BlazingPlanet/TVC-Flight-Software/flight_1/flight1.gif

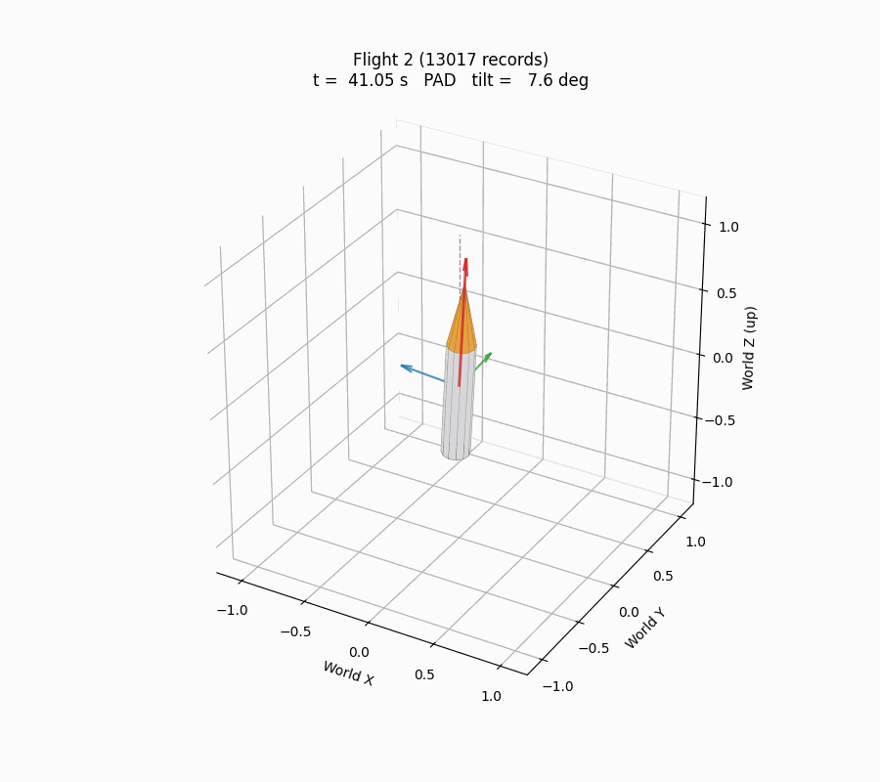
flight_1/flight1.gif
