BlazingPlanet/TVC-Flight-Software/TVC_Flight_Software/TVC_Flight_Software.ioc

Mcu.UserName=STM32F411CEUx
PA2.Signal=USART2_TX
PA3.Signal=USART2_RX
PA5.Signal=SPI1_SCK
PA6.Signal=SPI1_MISO
PA7.Signal=SPI1_MOSI
PB0.Signal=S_TIM3_CH3
PB10.GPIO_Label=FLASH_CS
PB10.Signal=GPIO_Output
PB12.GPIO_Label=IMU_CS
PB12.Signal=GPIO_Output
PB4.Signal=S_TIM3_CH1
PB5.Signal=S_TIM3_CH2
PB6.GPIO_Label=BMP_CS
PB6.Signal=GPIO_Output
