BlazingPlanet/TVC-Flight-Software/TVC_Flight_Software/Core/Inc/main.h

#define FLASH_CS_Pin GPIO_PIN_10
#define FLASH_CS_GPIO_Port GPIOB
#define IMU_CS_Pin GPIO_PIN_12
#define IMU_CS_GPIO_Port GPIOB
#define BMP_CS_Pin GPIO_PIN_6
#define BMP_CS_GPIO_Port GPIOB
