BlazingPlanet/TVC-Flight-Software/(commit log)

2026-09-08 Initial commit: TVC flight software as flown on flight 1
2026-10-07 flight 2 servo trim and max/min deflects for fresh TVC Mount
2026-10-07 updated servo trim and max/min deflect in CALIBRATION.MD
2026-11-07 update trim lines in servo pulse in decoder. udpated location for ##Decode in README.md in tools folder
2026-11-07 Add flight 2 post-flight analysis
    Motor vibration corrupted the gyro: a fake rate drove the gimbal to full deflection at the thrust spike, and the resulting rotation was under-reported, so the controller never corrected it. Includes README, liftoff analysis script, and figures. Supersedes the flight 1 crooked-rail conclusion.
2026-11-12 Arm hold to 10s. Burnout accel threshold update. Backup eject time updated. Ready for Flight 3
