BlazingPlanet/TVC-Flight-Software/(notices)

Notices in the files:
TVC_Flight_Software/Core/Inc/main.h:
Copyright (c) 2026 STMicroelectronics.
All rights reserved.
This software is licensed under terms that can be found in the LICENSE file
